tongtongwang86/steno/PCB/3d/SSD1306_OLED-0.91-128x32.step

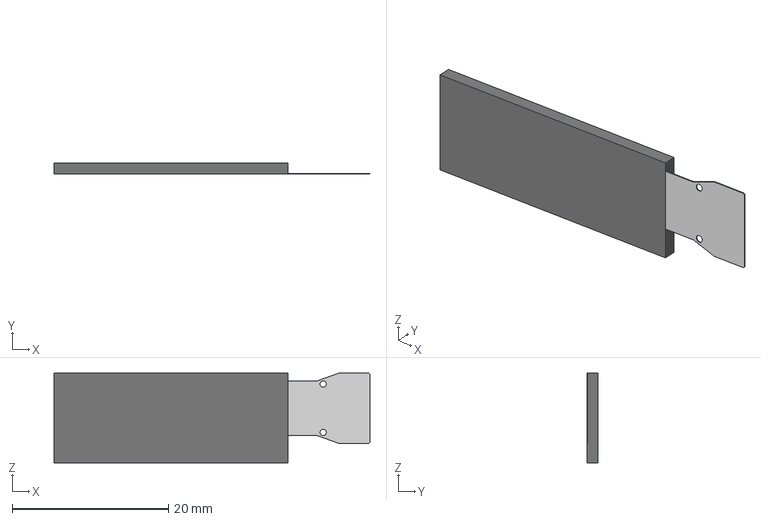
[picture p1: CAD file, 2025-06-24]
PCB/3d/SSD1306_OLED-0.91-128x32.step
40.5 x 1.45 x 11.5 mm
