tongtongwang86/steno/PCB/3d/APDS-9960.step

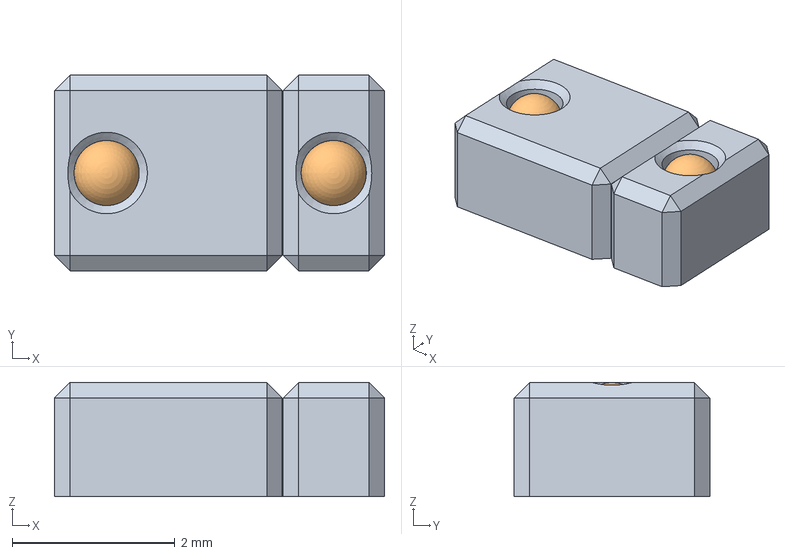
[picture p2: CAD file, 2025-06-24]
PCB/3d/APDS-9960.step
4.05 x 2.40 x 1.40 mm
