tongtongwang86/steno/PCB/3d/usbc.step

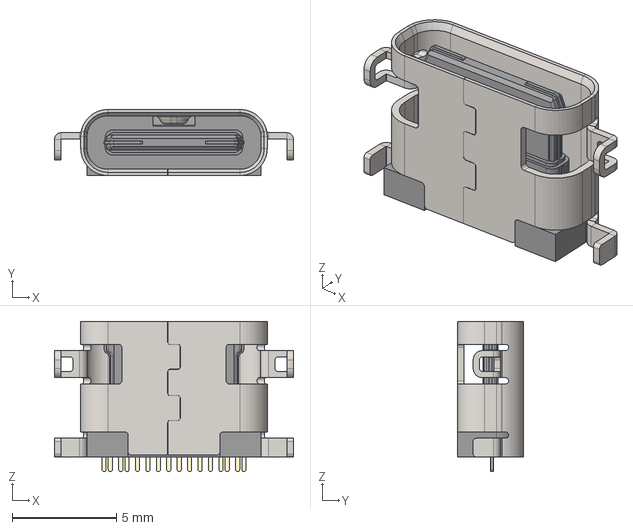
[picture p3: CAD file, 2025-06-24]
PCB/3d/usbc.step
11.5 x 3.16 x 7.20 mm
USB-C inboard metal
USB-C plastic
