tongtongwang86/steno/PCB/3d/WLCSP94_3P5X3P6_NOR.step

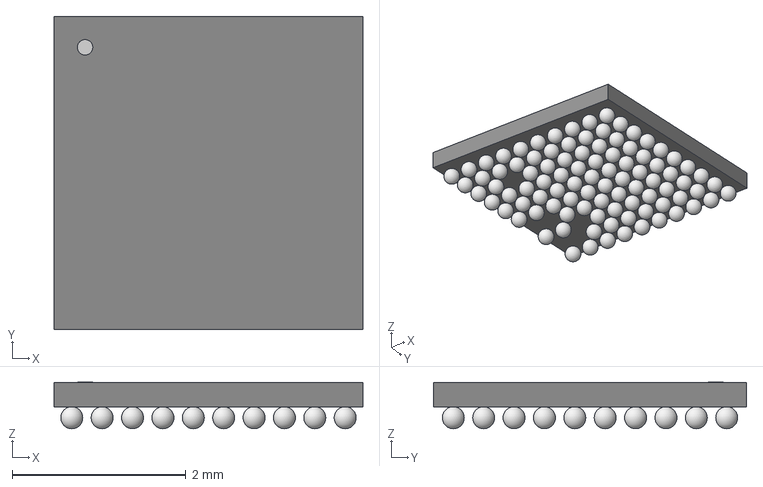
[picture p4: CAD file, 2025-06-24]
PCB/3d/WLCSP94_3P5X3P6_NOR.step
3.56 x 3.61 x 0.536 mm
