tongtongwang86/steno/PCB/3d/Chip Antenna.step

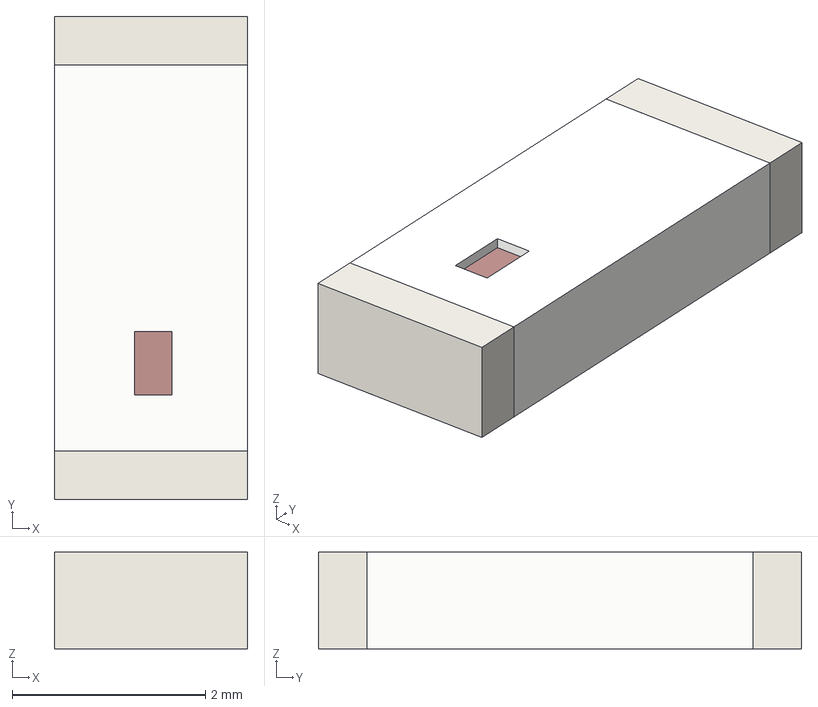
[picture p5: CAD file, 2025-06-24]
PCB/3d/Chip Antenna.step
2.00 x 5.00 x 1.00 mm
