tongtongwang86/steno/PCB/3d/CustomHotswap.step

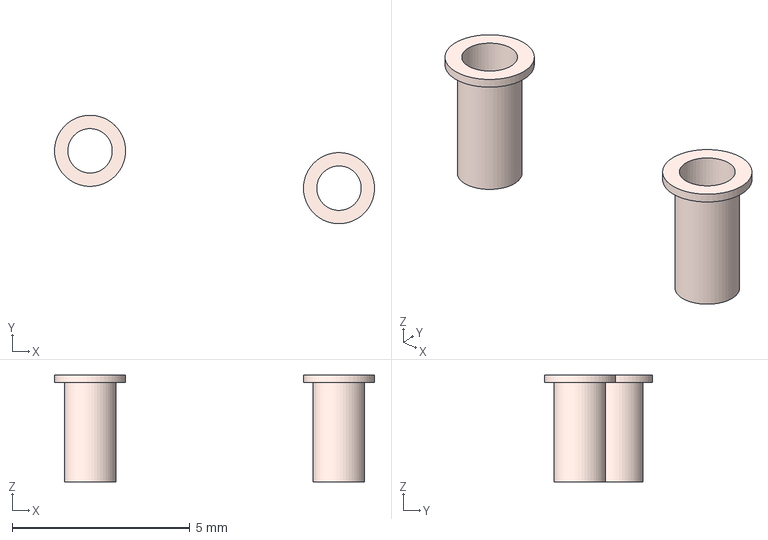
[picture p6: CAD file, 2025-06-24]
PCB/3d/CustomHotswap.step
9.00 x 3.05 x 3.00 mm
