tongtongwang86/steno/PCB/3d/pogo_T1836 v1.step

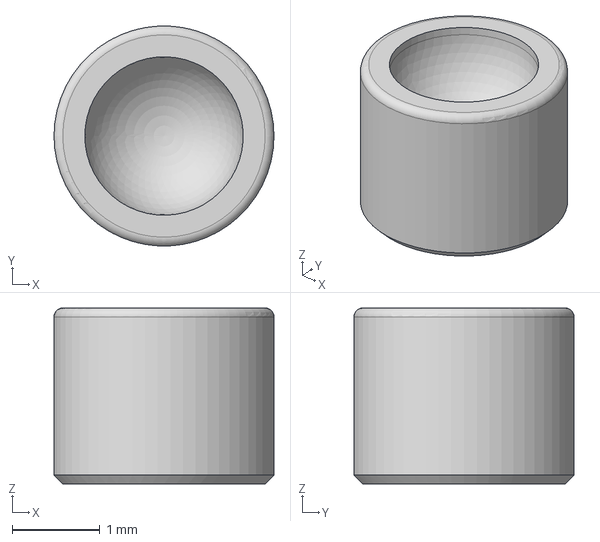
[picture p7: CAD file, 2025-06-24]
PCB/3d/pogo_T1836 v1.step
2.50 x 2.50 x 2.00 mm
