tongtongwang86/steno/PCB/3d/BK13C06-10DS2-0.35V_3D_STP.stp

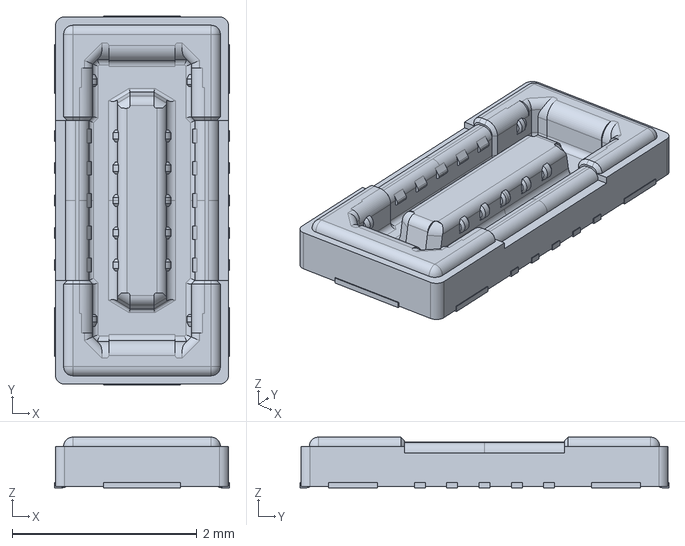
[picture p8: CAD file, 2025-06-24]
PCB/3d/BK13C06-10DS2-0.35V_3D_STP.stp
1.90 x 4.00 x 0.55 mm
