tongtongwang86/steno/PCB/3d/Inductor v1.step

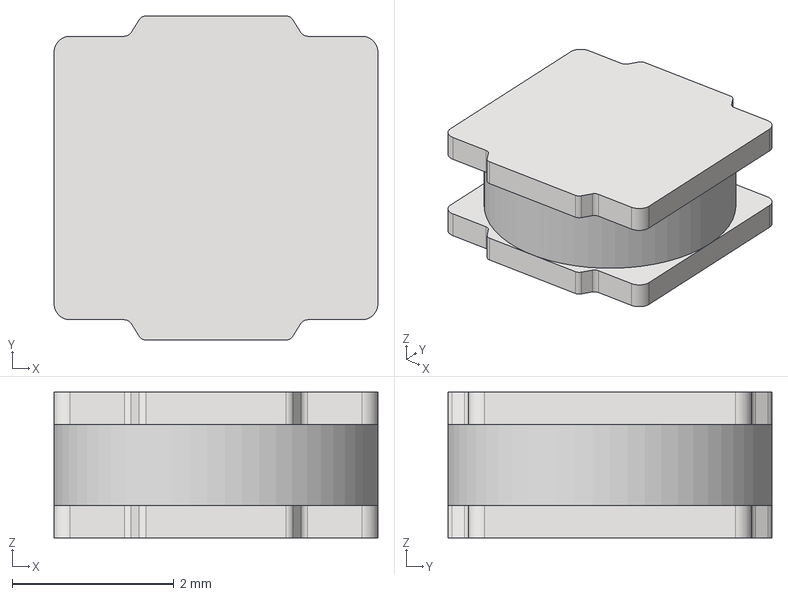
[picture p9: CAD file, 2025-06-24]
PCB/3d/Inductor v1.step
4.00 x 4.00 x 1.80 mm
