tongtongwang86/steno/PCB/3d/256Mbit GD25Q.step

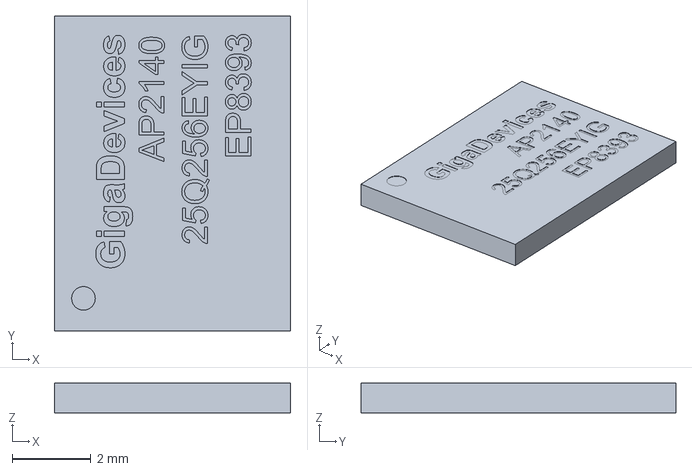
[picture p10: CAD file, 2025-06-24]
PCB/3d/256Mbit GD25Q.step
6.00 x 8.00 x 0.75 mm
