tongtongwang86/steno/PCB/3d/button v4.step

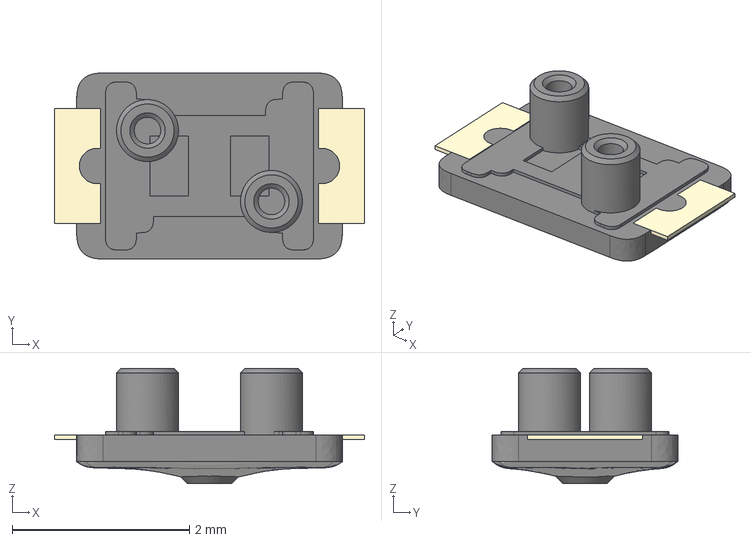
[picture p11: CAD file, 2025-06-24]
PCB/3d/button v4.step
3.50 x 2.10 x 1.30 mm
base
slider
