tongtongwang86/steno/PCB/3d/m3808 pogofemale v3.step

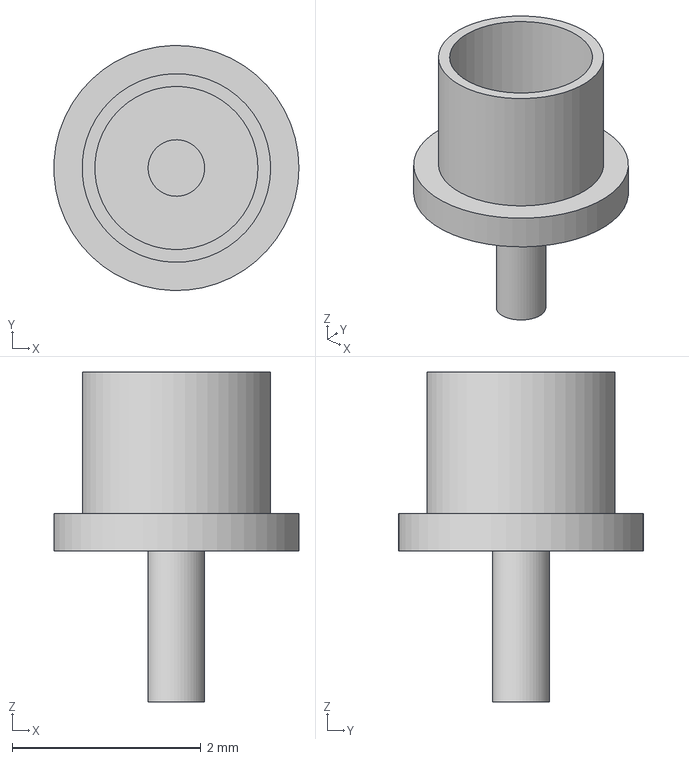
[picture p12: CAD file, 2025-06-24]
PCB/3d/m3808 pogofemale v3.step
2.60 x 2.60 x 3.50 mm
