tongtongwang86/steno/PCB/3d/USB2 v3.step

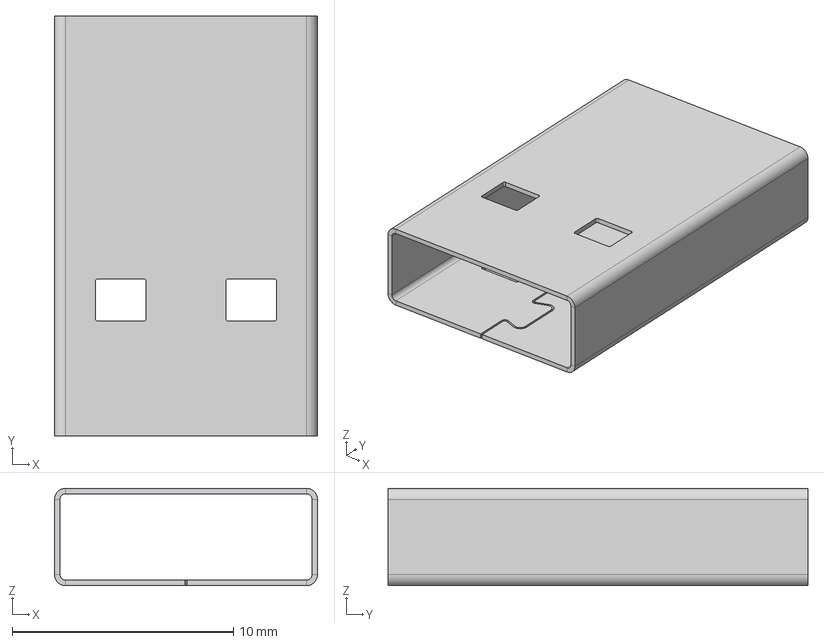
[picture p13: CAD file, 2025-06-24]
PCB/3d/USB2 v3.step
11.9 x 19.0 x 4.40 mm
