tongtongwang86/steno/PCB/3d/button3.step

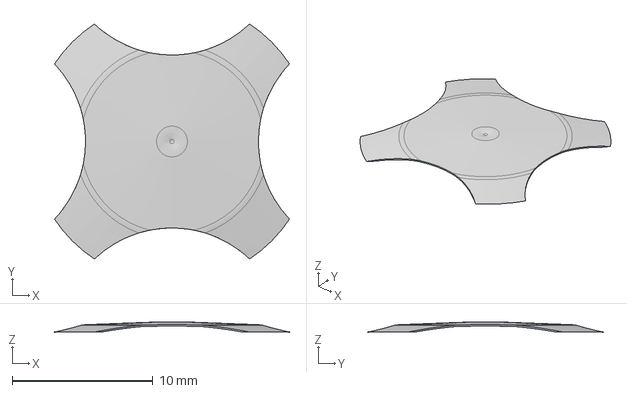
[picture p14: CAD file, 2025-06-24]
PCB/3d/button3.step
16.7 x 16.7 x 0.722 mm
