tongtongwang86/steno/PCB/3d/SW_Hotswap_Kailh_Choc_v1.stp

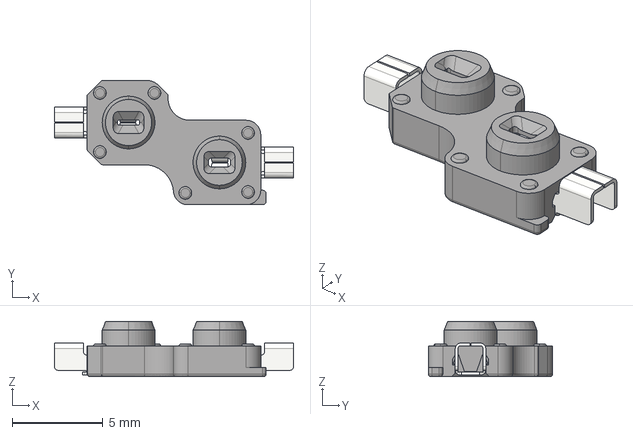
[picture p15: CAD file, 2025-06-24]
PCB/3d/SW_Hotswap_Kailh_Choc_v1.stp
13.2 x 6.85 x 3.05 mm
