tongtongwang86/steno/PCB/3d/Antenna.step

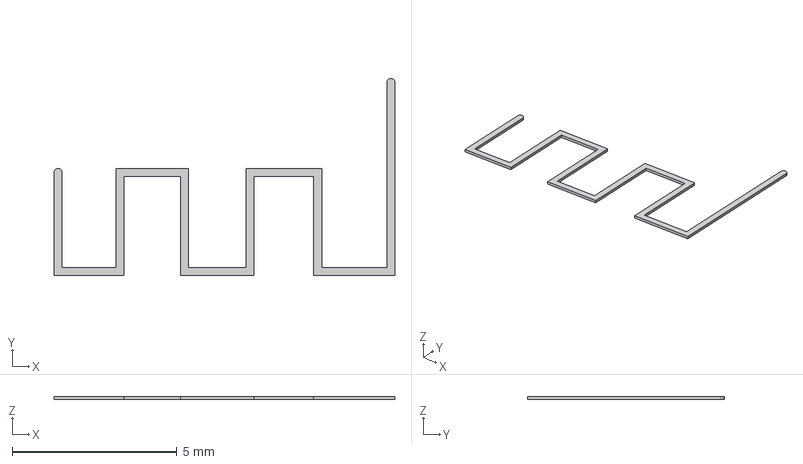
[picture p16: CAD file, 2025-06-24]
PCB/3d/Antenna.step
10.3 x 5.98 x 0.1 mm
