tongtongwang86/steno/PCB/3d/Battery2 v1.step

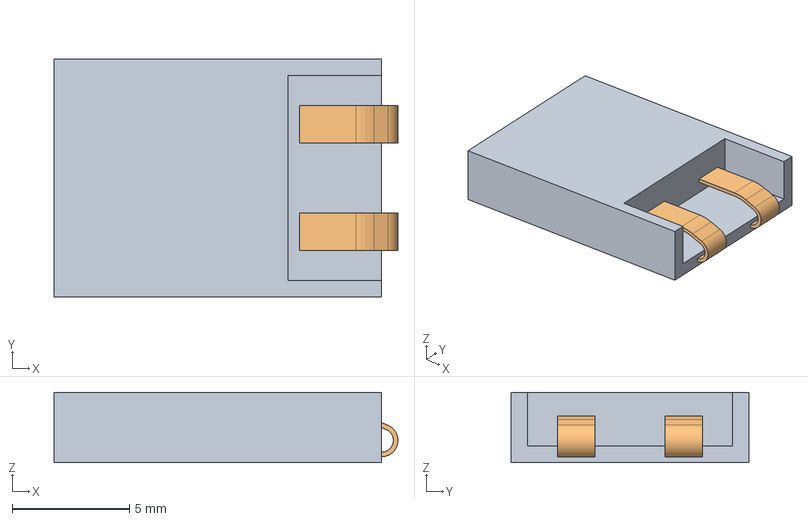
[picture p17: CAD file, 2025-06-24]
PCB/3d/Battery2 v1.step
14.7 x 10.2 x 3.00 mm
