tongtongwang86/steno/PCB/3d/buttoncompliant v4.step

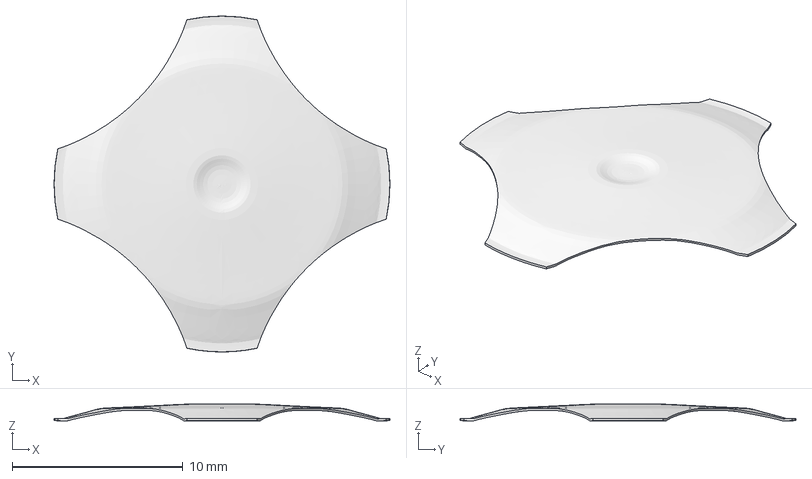
[picture p18: CAD file, 2025-06-24]
PCB/3d/buttoncompliant v4.step
19.7 x 19.7 x 0.979 mm
