tongtongwang86/steno/PCB/3d/FPC ZIF.step

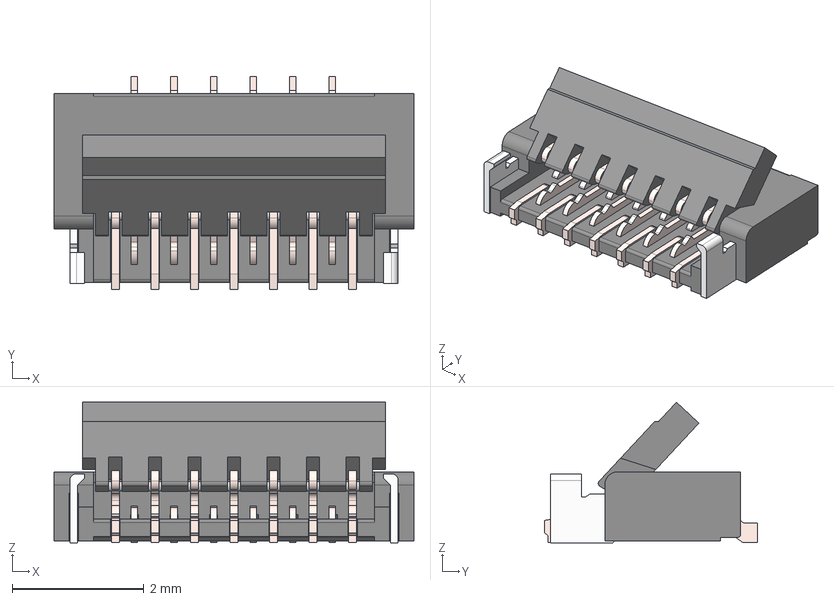
[picture p19: CAD file, 2025-06-24]
PCB/3d/FPC ZIF.step
5.46 x 3.23 x 2.13 mm
