tongtongwang86/steno/PCB/3d/KailhChocV2.step

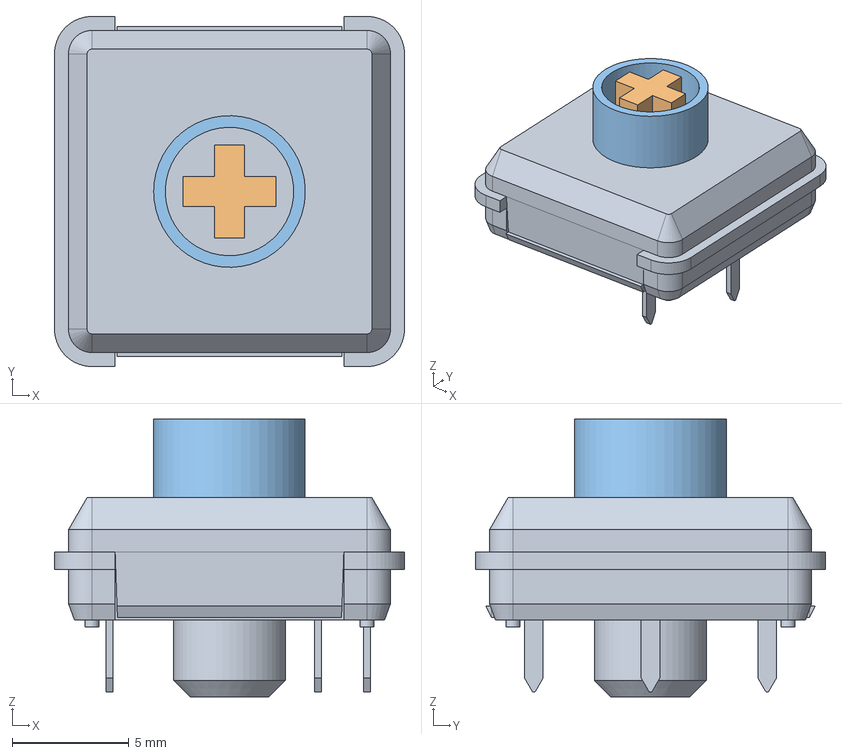
[picture p20: CAD file, 2025-06-24]
PCB/3d/KailhChocV2.step
15.0 x 15.0 x 11.9 mm
Plunger
