tongtongwang86/steno/PCB/3d/32MHZ Clock v1.step

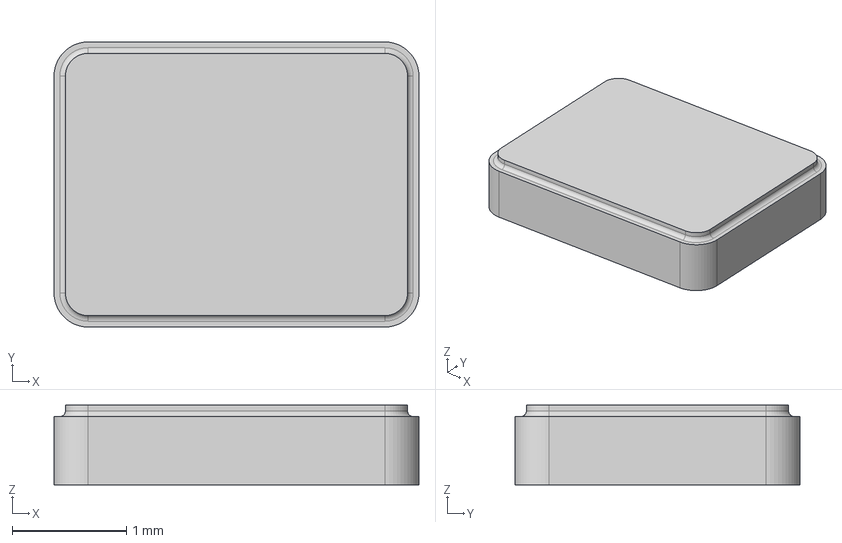
[picture p21: CAD file, 2025-06-24]
PCB/3d/32MHZ Clock v1.step
3.20 x 2.50 x 0.7 mm
