tongtongwang86/steno/PCB/3d/GateronHotswap v3.step

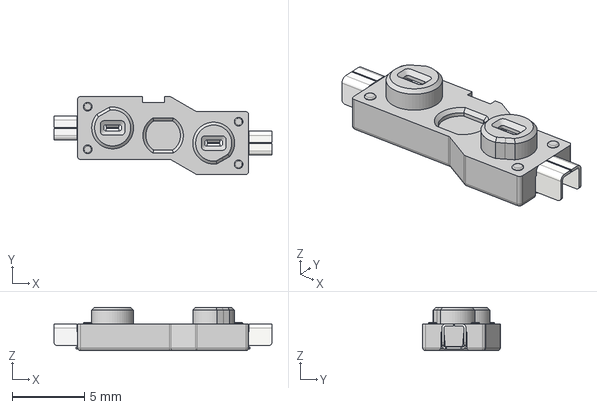
[picture p22: CAD file, 2025-06-24]
PCB/3d/GateronHotswap v3.step
15.1 x 5.39 x 3.00 mm
