tongtongwang86/steno/PCB/3d/Button.step

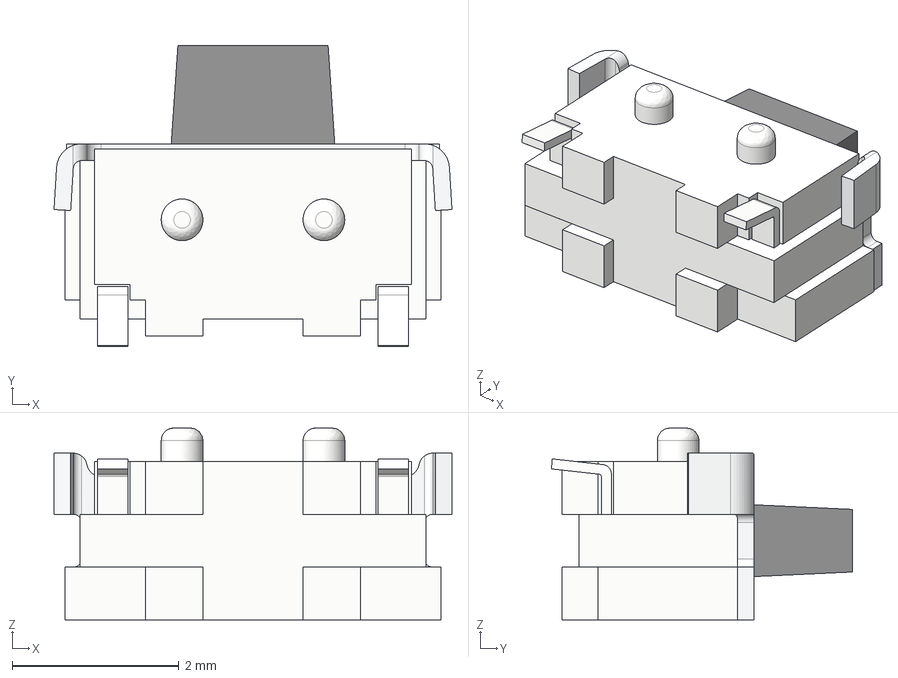
[picture p23: CAD file, 2025-06-24]
PCB/3d/Button.step
4.77 x 3.61 x 2.30 mm
Slider
