tongtongwang86/steno/PCB/3d/BK13C06-10DP2-0.35V_3D_STP.stp

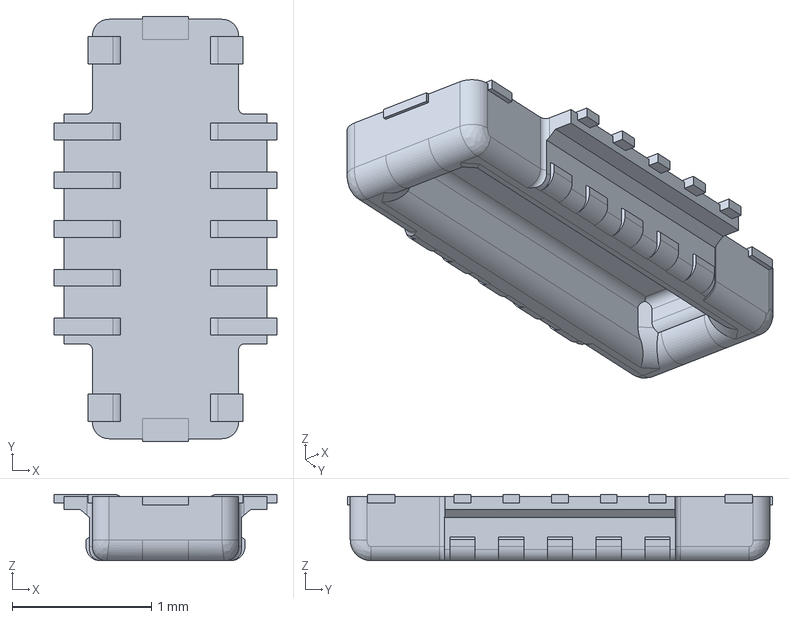
[picture p24: CAD file, 2025-06-24]
PCB/3d/BK13C06-10DP2-0.35V_3D_STP.stp
1.60 x 3.05 x 0.475 mm
