tongtongwang86/steno/PCB/3d/buttoncompliant.step

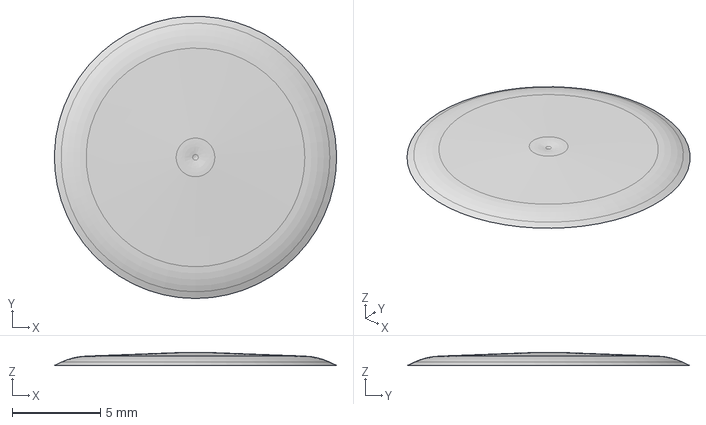
[picture p25: CAD file, 2025-06-24]
PCB/3d/buttoncompliant.step
16.0 x 16.0 x 0.722 mm
