tongtongwang86/steno/PCB/3d/BatteryBase.step

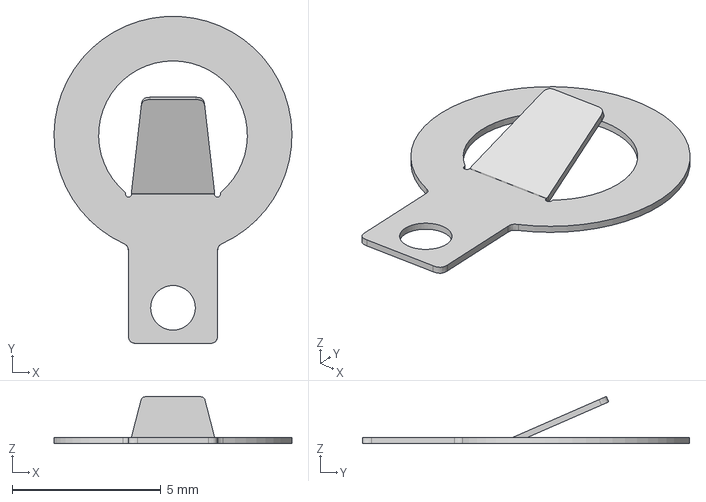
[picture p26: CAD file, 2025-06-24]
PCB/3d/BatteryBase.step
8.00 x 11.0 x 1.59 mm
