tongtongwang86/steno/PCB/3d/Battery v2.step

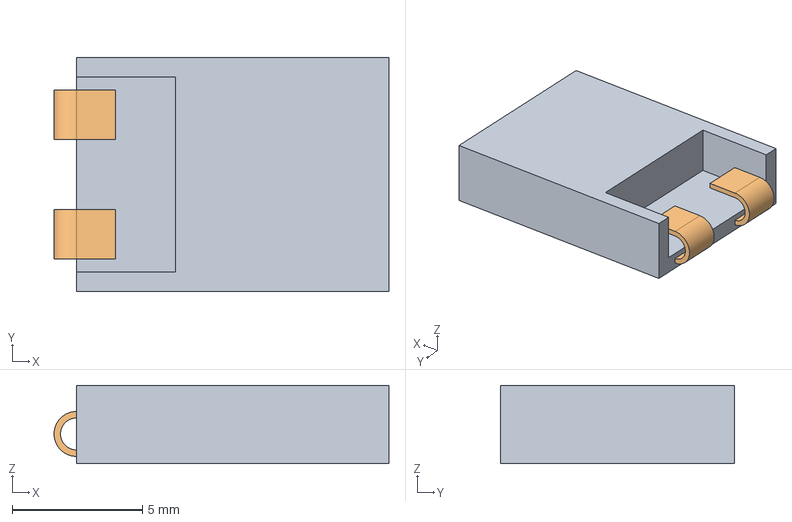
[picture p27: CAD file, 2025-06-24]
PCB/3d/Battery v2.step
12.9 x 9.00 x 3.00 mm
