tongtongwang86/steno/PCB/3d/Humidity.step

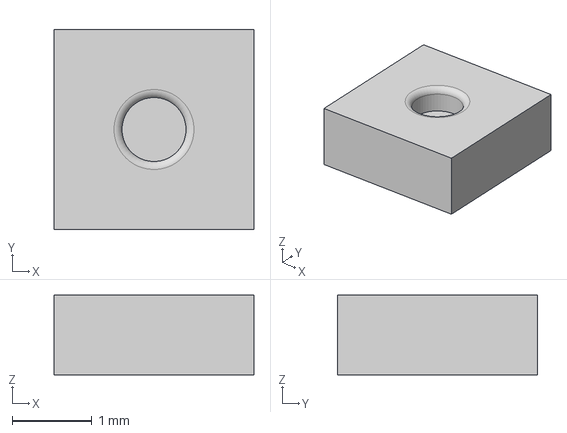
[picture p28: CAD file, 2025-06-24]
PCB/3d/Humidity.step
2.50 x 2.50 x 1.00 mm
