tongtongwang86/steno/PCB/3d/SPK0641HT4H-1.step

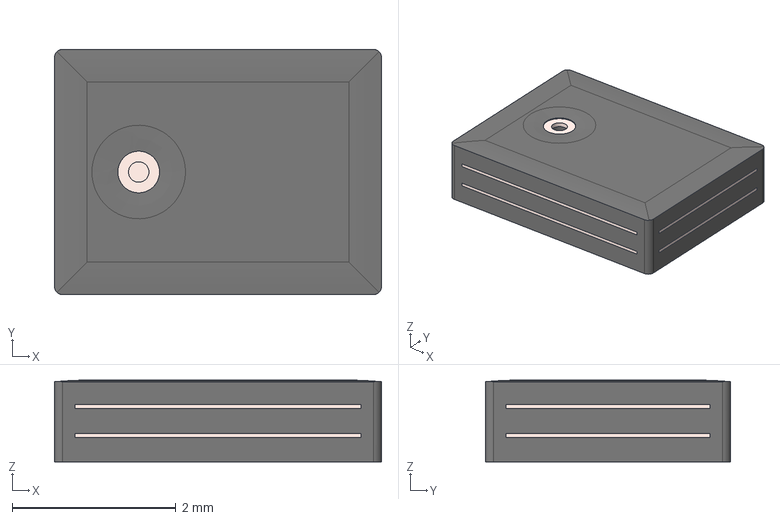
[picture p29: CAD file, 2025-06-24]
PCB/3d/SPK0641HT4H-1.step
4.00 x 3.00 x 1.00 mm
