tongtongwang86/steno/PCB/3d/Crystal 2 v0.step

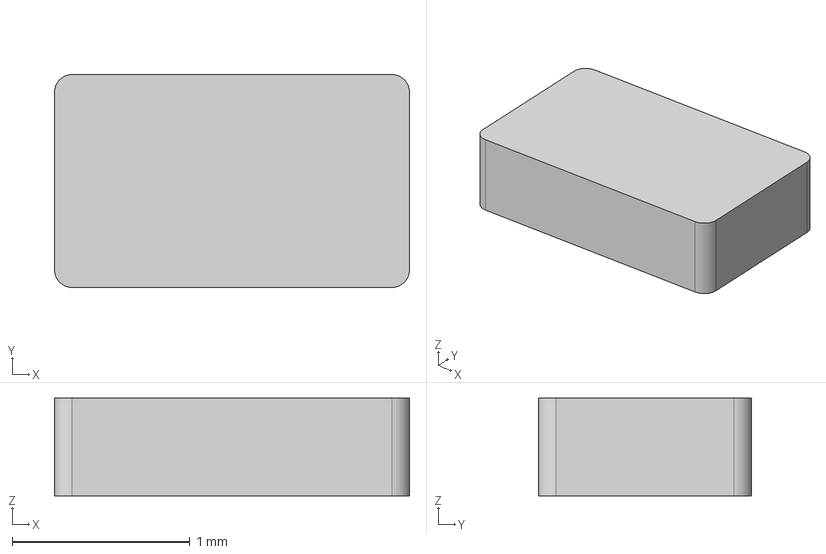
[picture p30: CAD file, 2025-06-24]
PCB/3d/Crystal 2 v0.step
2.00 x 1.20 x 0.55 mm
