tongtongwang86/steno/PCB/3d/LedV2 v4.step

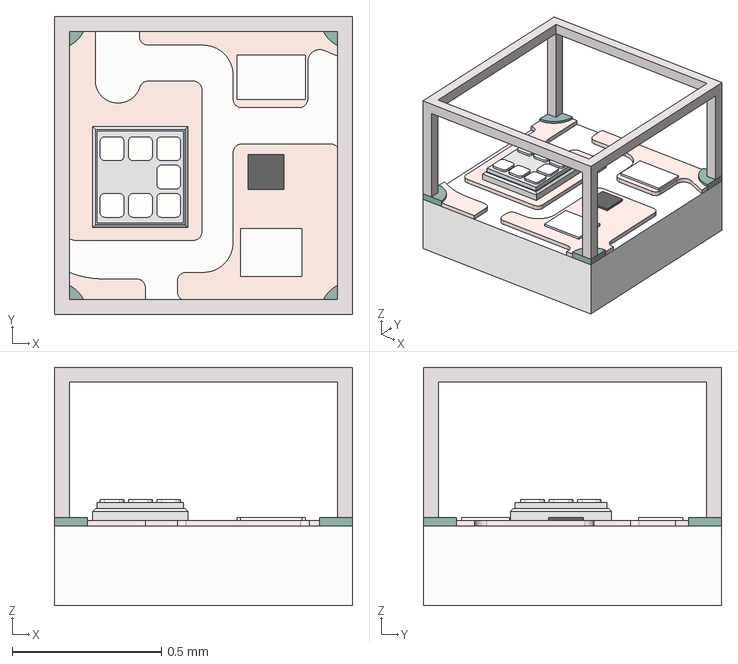
[picture p31: CAD file, 2025-06-24]
PCB/3d/LedV2 v4.step
1.00 x 1.00 x 0.8 mm
