tongtongwang86/steno/PCB/3d/TDFN-4 v1.step

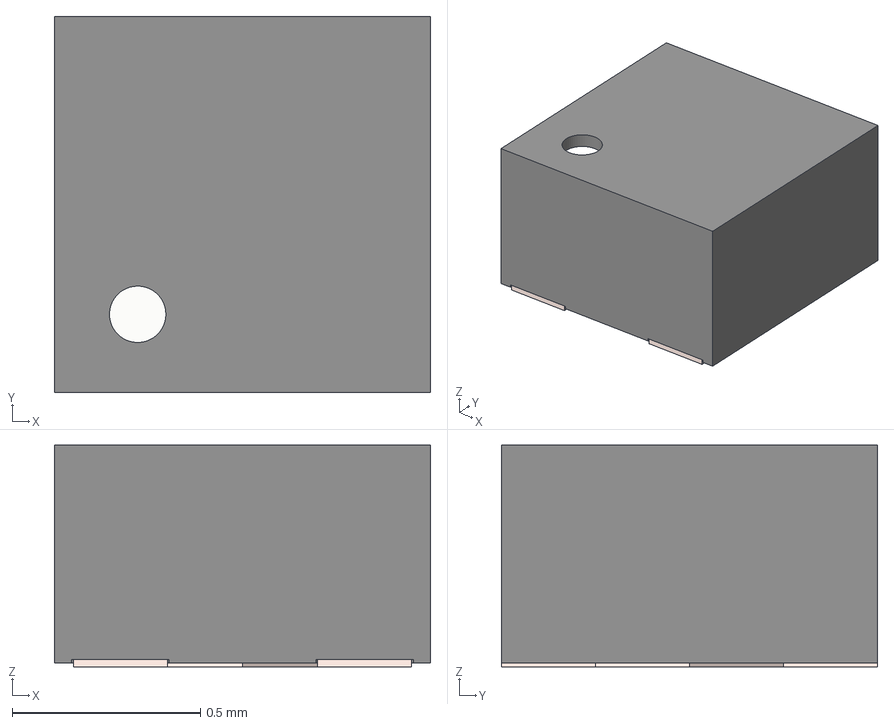
[picture p32: CAD file, 2025-06-24]
PCB/3d/TDFN-4 v1.step
1.00 x 1.00 x 0.59 mm
