tongtongwang86/steno/PCB/3d/QFN_2016_4pins.STEP

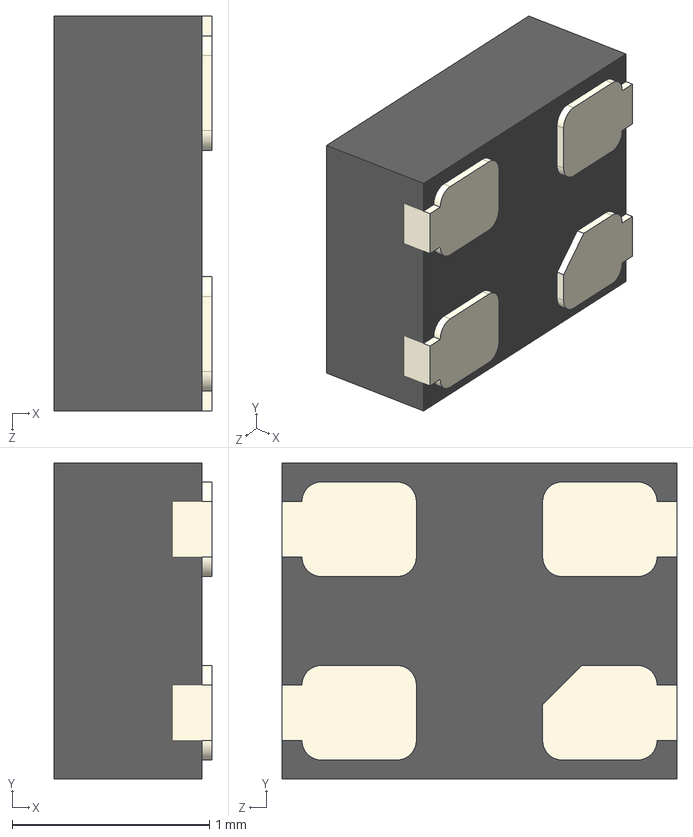
[picture p33: CAD file, 2025-06-24]
PCB/3d/QFN_2016_4pins.STEP
0.8 x 1.60 x 2.00 mm
