tongtongwang86/steno/PCB/3d/Pdmmic.step

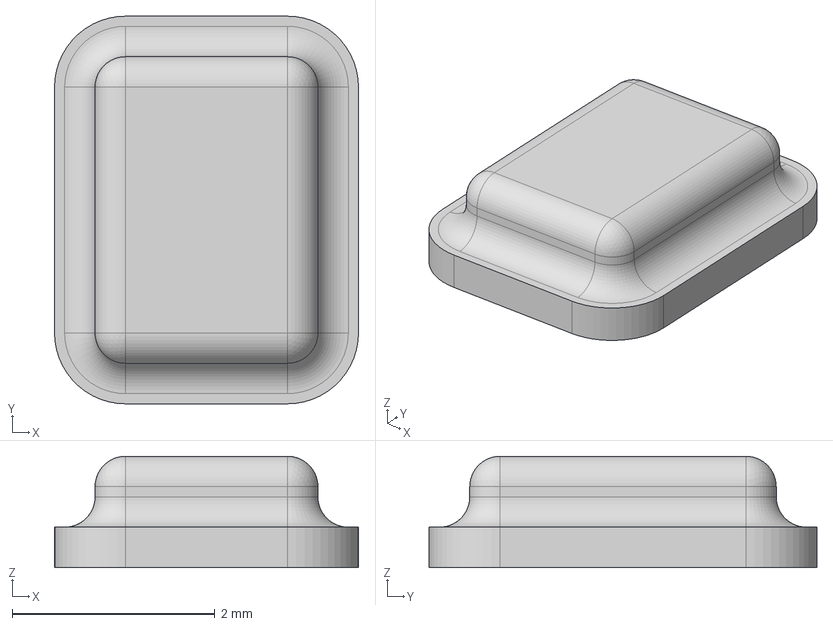
[picture p34: CAD file, 2025-06-24]
PCB/3d/Pdmmic.step
3.00 x 3.83 x 1.10 mm
