tongtongwang86/steno/PCB/3d/Speaker.step

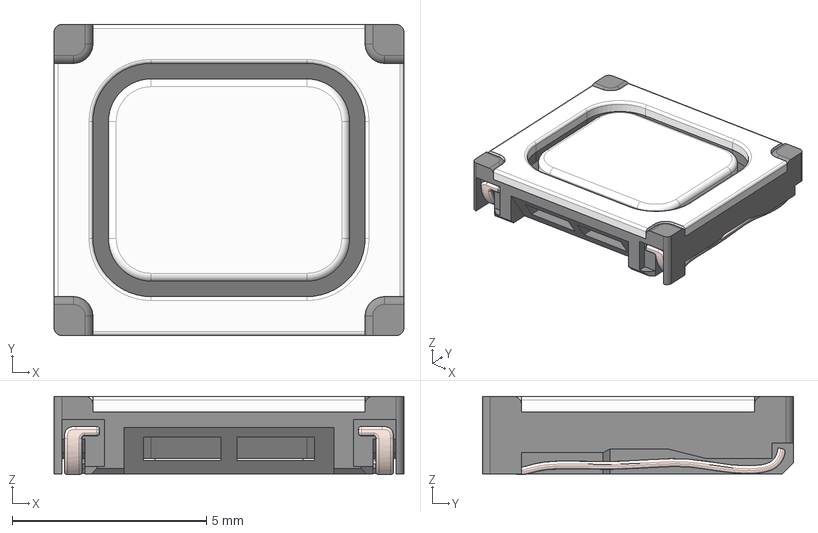
[picture p35: CAD file, 2025-06-24]
PCB/3d/Speaker.step
9.00 x 8.00 x 2.01 mm
bottom cap
case
diaphram
leg2
leg1
