tongtongwang86/steno/PCB/3d/5x5x1.7 v1.step

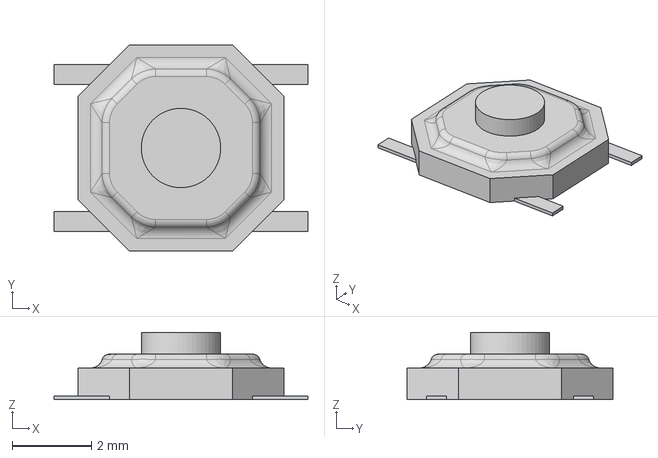
[picture p36: CAD file, 2025-06-24]
PCB/3d/5x5x1.7 v1.step
6.40 x 5.20 x 1.70 mm
