tongtongwang86/steno/(list of files, cad)

Other CAD files:
PCB/3d/USB - C inboard.step
PCB/3d/CSD17381F4.STEP
PCB/3d/NRF52832-CIAA-R.step
