tongtongwang86/steno/PCB/plots/Steno__Assembly.pdf

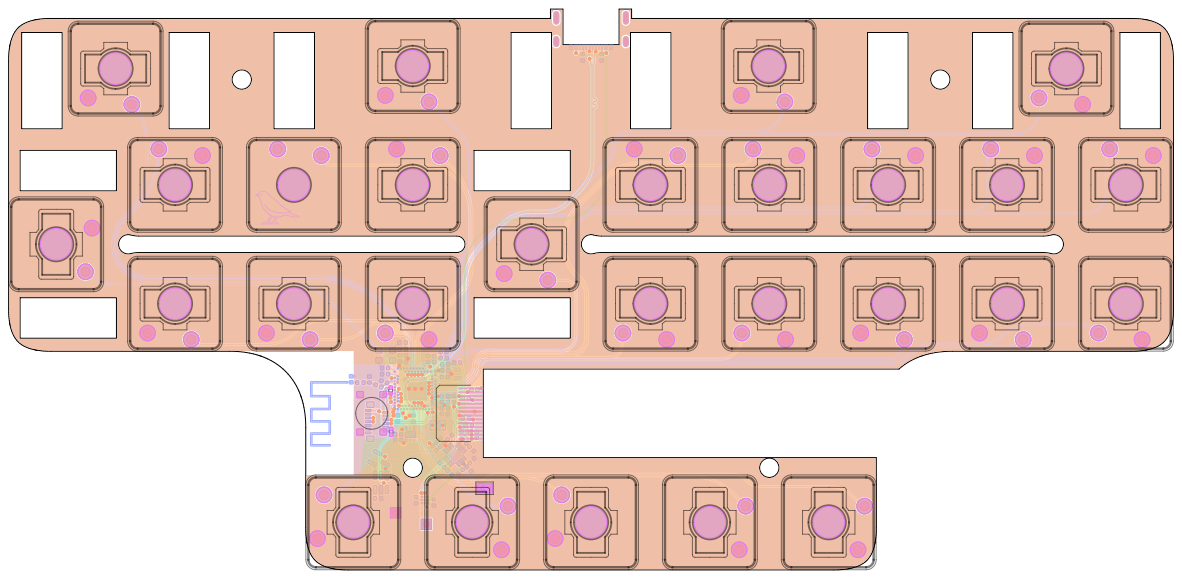
[picture p37: page 1]
