tongtongwang86/steno/PCB/Steno.kicad_pcb

## KiCad design PCB/Steno.kicad_pcb (2025-07-06)

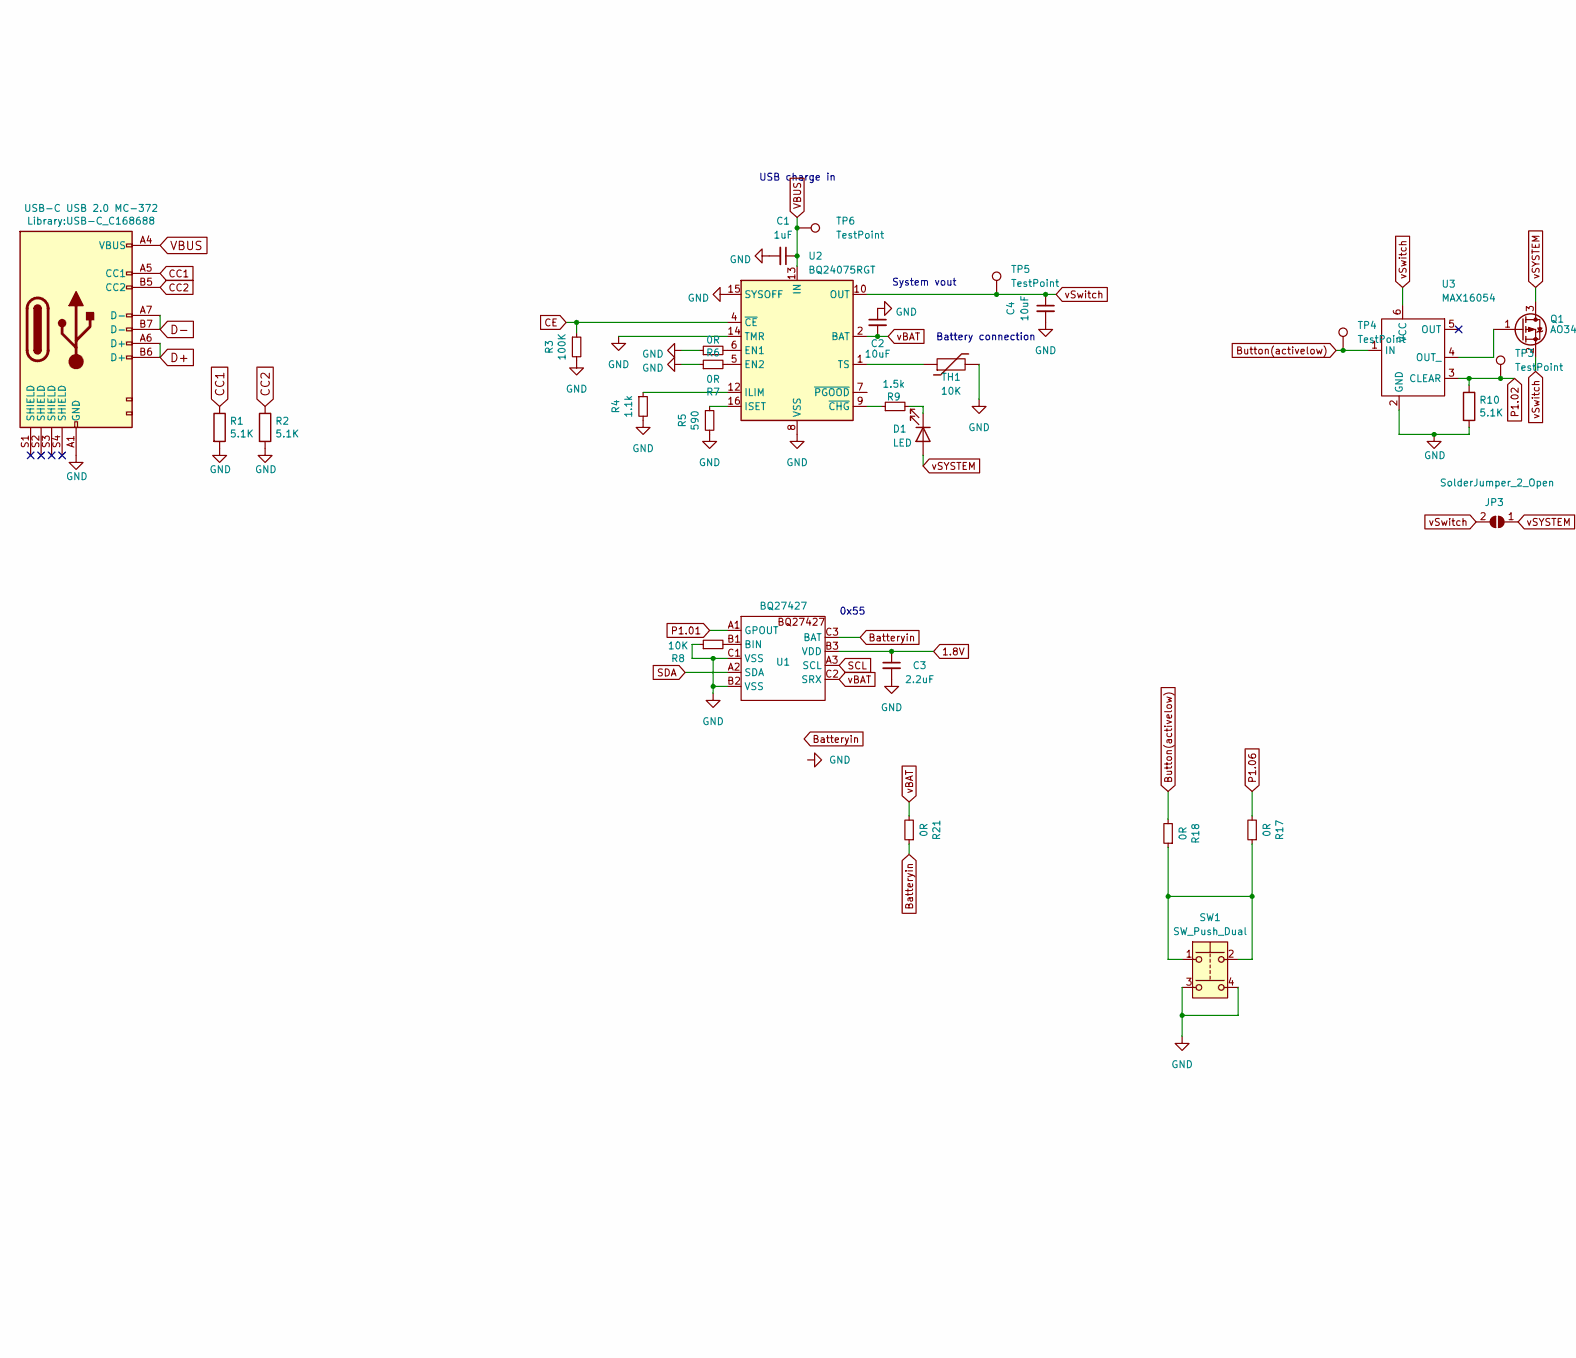
[picture p38: schematic Steno.kicad_sch, part in row 1, column 1]

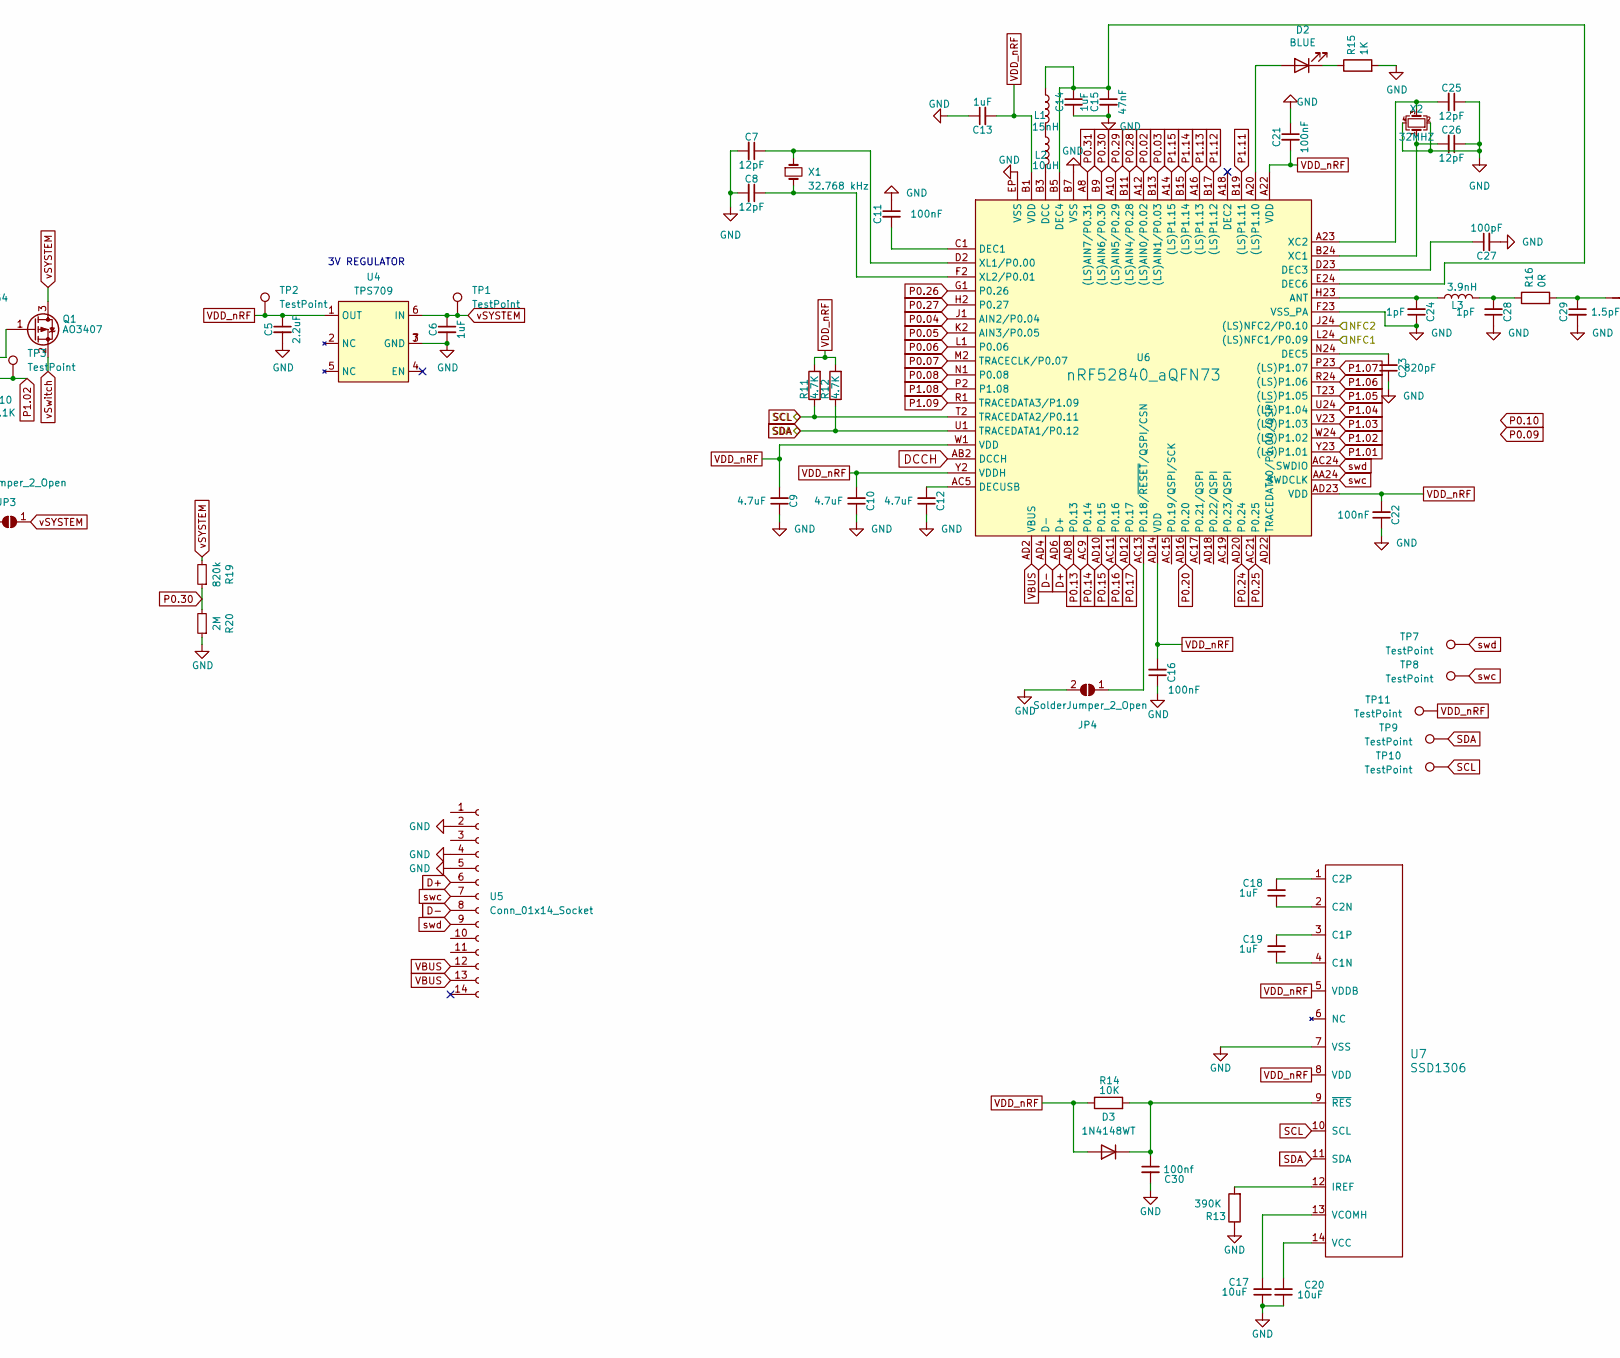
[picture p39: schematic Steno.kicad_sch, part in row 1, column 2]

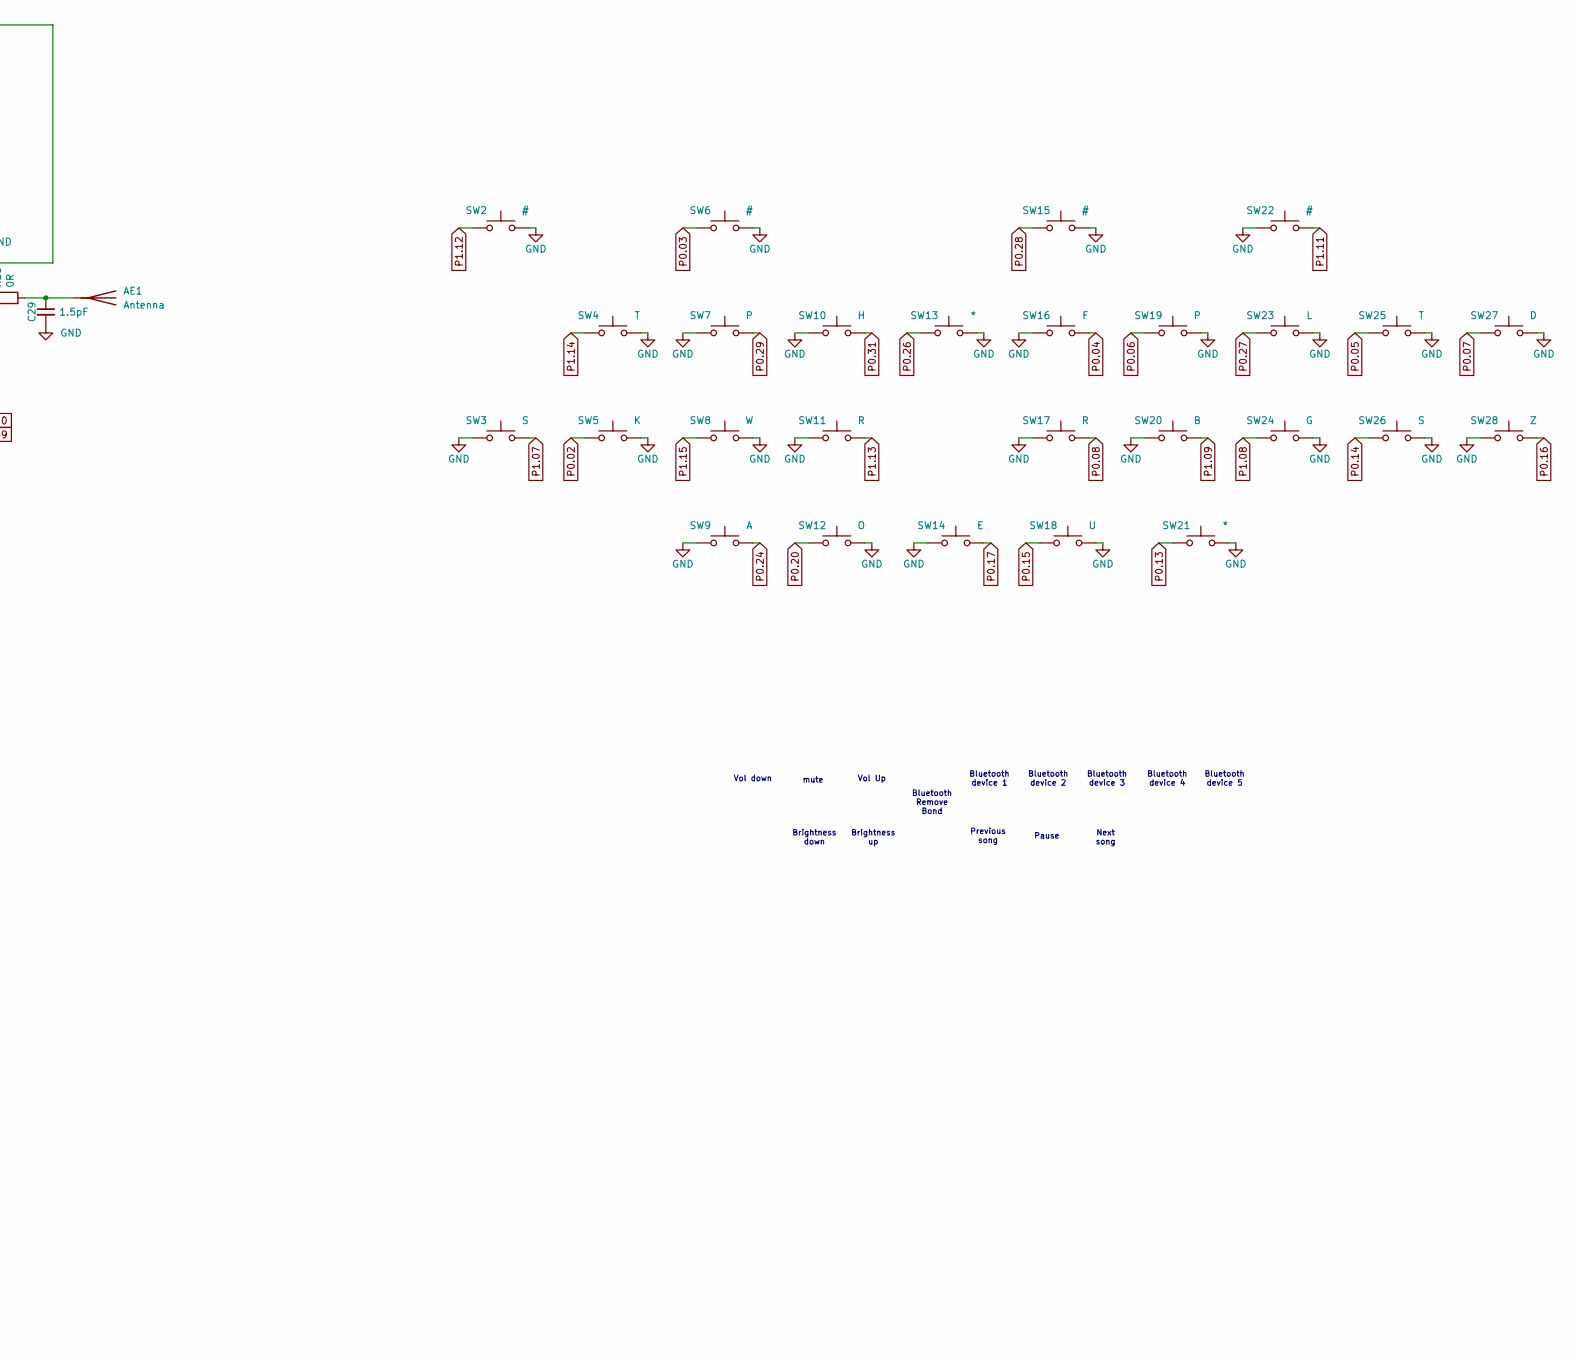
[picture p40: schematic Steno.kicad_sch, part in row 1, column 3]

Parts:
AE1: Antenna; 2.4GHz-meander-antenna-v2
C1, C6: 1uF; 0402
C2, C4, C17, C20: 10uF; 0402
C3, C5: 2.2uF; 0402
C7, C8, C25, C26: 12pF; C_0402_1005Metric
C9, C10, C12: 4.7uF; C_0402_1005Metric
C11, C16, C21, C22: 100nF; C_0402_1005Metric
C13, C14, C18, C19: 1uF; C_0402_1005Metric
C15: 47nF; C_0402_1005Metric
C23: 820pF; C_0402_1005Metric
C24, C28: 1pF; C_0402_1005Metric
C27: 100pF; C_0402_1005Metric
C29: 1.5pF; C_0402_1005Metric
C30: 100nf; C_0402_1005Metric
D1: LED; 0402
D2: BLUE; LED_0402_1005Metric
D3: 1N4148WT; D_SOD-523
J1: USB-C USB 2.0 MC-372; USB-C_C168688
JP3, JP4: SolderJumper_2_Open; SolderJumper-2_P1.3mm_Open_TrianglePad1.0x1.5mm
L1: 15nH; L_0402_1005Metric
L2: 10uH; L_0402_1005Metric
L3: 3.9nH; L_0402_1005Metric
Q1: AO3407; SOT-23
R1, R2, R10: 5.1K; R_0402_1005Metric
R3: 100K; 0402
R4: 1.1k; 0402
R5: 590; 0402
R6, R7, R16, R17, R18, R21: 0R; 0402
R8, R14: 10K; 0402
R9: 1.5k; 0402
R11, R12: 4.7K; R_0402_1005Metric
R13: 390K; R_0402_1005Metric
R15: 1K; R_0402_1005Metric
R19: 820k; 0402
R20: 2M; 0402
SW1: SW_Push_Dual; 5x5button
SW2, SW6, SW15, SW22: #; CustomHotswap
SW3, SW26: S; CustomHotswap
SW4, SW25: T; CustomHotswap
SW5: K; CustomHotswap
SW7, SW19: P; CustomHotswap
SW8: W; CustomHotswap
SW9: A; CustomHotswap
SW10: H; CustomHotswap
SW11, SW17: R; CustomHotswap
SW12: O; CustomHotswap
SW13, SW21: *; CustomHotswap
SW14: E; CustomHotswap
SW16: F; CustomHotswap
SW18: U; CustomHotswap
SW20: B; CustomHotswap
SW23: L; CustomHotswap
SW24: G; CustomHotswap
SW27: D; CustomHotswap
SW28: Z; CustomHotswap
TH1: 10K; 0402
TP1, TP2, TP3, TP4, TP5, TP6, TP7, TP8, TP9, TP10, TP11: TestPoint; testPads
U1: BQ27427; Texas_DSBGA-9_1.62mmx1.58mm_Layout3x3_P0.5mm
U2: BQ24075RGT; VQFN-16-1EP_3x3mm_P0.5mm_EP1.6x1.6mm
U3: MAX16054; SOT-23-6
U4: TPS709; DRV 6PIN
U5: Conn_01x14_Socket; FPC
U6: nRF52840_aQFN73; AQFN-73-1EP_7x7mm_P0.5mm_NRF52840-custom
U7: SSD1306; SSD1306_OLED-0.91-128x32
X1: 32.768 kHz; Crystal_SMD_2012-2Pin_2.0x1.2mm; Manufacturer Part SC20S-12.5PF20PPM; LCSC Part C97607
X2: 32MHZ; crystal 32mhz

Connections:
1.8V: C3.1, U1.B3 (VDD)
/NFC1: U6.L24 ((LS)NFC1/P0.09)
/NFC2: U6.J24 ((LS)NFC2/P0.10)
Batteryin: R21.1, U1.C3 (BAT)
Button(activelow): R18.2, TP4.1, U3.1 (IN)
CC1: J1.A5 (CC1), R1.1
CC2: J1.B5 (CC2), R2.1
CE: R3.1, U2.4 (~CE)
D+: J1.A6 (D+), J1.B6 (D+), U5.6, U6.AD6 (D+)
D-: J1.A7 (D-), J1.B7 (D-), U5.8, U6.AD4 (D-)
DCCH: U6.AB2 (DCCH)
GND: C1.2, C2.1, C3.2, C4.2, C5.2, C6.2, C7.2, C8.2, C9.1, C10.1, C11.1, C12.1, C13.1, C14.2, C15.2, C16.1, C17.1, C20.1, C21.1, C22.1, C23.1, C24.1, C25.1, C26.1, C27.2, C28.1, C29.2, C30.2, J1.A1 (GND), JP4.2 (B), R1.2, R2.2, R3.2, R4.2, R5.2, R6.1, R7.1, R8.1, R10.2, R13.1, R15.2, R20.1, SW1.3, SW1.4, SW2.2, SW3.1, SW4.2, SW5.2, SW6.2, SW7.1, SW8.2, SW9.1, SW10.1, SW11.1, SW12.2, SW13.2, SW14.1, SW15.2, SW16.1, SW17.1, SW18.2, SW19.2, SW20.1, SW21.2, SW22.1, SW23.2, SW24.2, SW25.2, SW26.2, SW27.2, SW28.1, TH1.2, U1.B2 (VSS), U1.C1 (VSS), U2.8 (VSS), U2.14 (TMR), U2.15 (SYSOFF), U2.17 (VSS), U3.2 (GND), U4.3 (GND), U4.7 (GND), U5.2, U5.4, U5.5, U6.B7 (VSS), U6.EP (VSS), U6.F23 (VSS_PA), U7.7 (VSS), X2.2, X2.4
unnamed: AE1.1 (A), C29.1, R16.2
unnamed: C28.2, L3.2, R16.1
unnamed: D1.1 (K), R9.2
unnamed: D2.2 (A), U6.A20 ((LS)P1.10)
unnamed: D2.1 (K), R15.1
unnamed: C30.1, D3.1 (K), R14.2, U7.9 (~RES)
unnamed: JP4.1 (A), U6.AC13 (P0.18/~RESET/QSPI/CSN)
unnamed: L1.2, L2.1
unnamed: Q1.1 (G), U3.4 (OUT_)
unnamed: R17.1, R18.1, SW1.1, SW1.2
unnamed: R8.2, U1.B1 (BIN)
unnamed: R6.2, U2.6 (EN1)
unnamed: R7.2, U2.5 (EN2)
unnamed: R4.1, U2.12 (ILIM)
unnamed: R5.1, U2.16 (ISET)
unnamed: TH1.1, U2.1 (TS)
unnamed: R9.1, U2.9 (~CHG)
unnamed: C24.2, L3.1, U6.H23 (ANT)
unnamed: L2.2, U6.B3 (DCC)
unnamed: C11.2, U6.C1 (DEC1)
unnamed: C27.1, U6.D23 (DEC3)
unnamed: C14.1, C15.1, L1.1, U6.B5 (DEC4), U6.E24 (DEC6)
unnamed: C23.2, U6.N24 (DEC5)
unnamed: C12.2, U6.AC5 (DECUSB)
unnamed: C26.2, U6.B24 (XC1), X2.1
unnamed: C25.2, U6.A23 (XC2), X2.3
unnamed: C7.1, U6.D2 (XL1/P0.00), X1.1
unnamed: C8.1, U6.F2 (XL2/P0.01), X1.2
unnamed: C19.1, U7.4 (C1N)
unnamed: C19.2, U7.3 (C1P)
unnamed: C18.1, U7.2 (C2N)
unnamed: C18.2, U7.1 (C2P)
unnamed: R13.2, U7.12 (IREF)
unnamed: C20.2, U7.14 (VCC)
unnamed: C17.2, U7.13 (VCOMH)
P0.02: SW5.1, U6.A12 ((LS)AIN0/P0.02)
P0.03: SW6.1, U6.B13 ((LS)AIN1/P0.03)
P0.04: SW16.2, U6.J1 (AIN2/P0.04)
P0.05: SW25.1, U6.K2 (AIN3/P0.05)
P0.06: SW19.1, U6.L1 (P0.06)
P0.07: SW27.1, U6.M2 (TRACECLK/P0.07)
P0.08: SW17.2, U6.N1 (P0.08)
P0.13: SW21.1, U6.AD8 (P0.13)
P0.14: SW26.1, U6.AC9 (P0.14)
P0.15: SW18.1, U6.AD10 (P0.15)
P0.16: SW28.2, U6.AC11 (P0.16)
P0.17: SW14.2, U6.AD12 (P0.17)
P0.20: SW12.1, U6.AD16 (P0.20)
P0.24: SW9.2, U6.AD20 (P0.24)
P0.25: U6.AC21 (P0.25)
P0.26: SW13.1, U6.G1 (P0.26)
P0.27: SW23.1, U6.H2 (P0.27)
P0.28: SW15.1, U6.B11 ((LS)AIN4/P0.28)
P0.29: SW7.2, U6.A10 ((LS)AIN5/P0.29)
P0.30: R19.1, R20.2, U6.B9 ((LS)AIN6/P0.30)
P0.31: SW10.2, U6.A8 ((LS)AIN7/P0.31)
P1.01: U1.A1 (GPOUT), U6.Y23 ((LS)P1.01)
P1.02: R10.1, TP3.1, U3.3 (CLEAR), U6.W24 ((LS)P1.02)
P1.03: U6.V23 ((LS)P1.03)
P1.04: U6.U24 ((LS)P1.04)
P1.05: U6.T23 ((LS)P1.05)
P1.06: R17.2, U6.R24 ((LS)P1.06)
P1.07: SW3.2, U6.P23 ((LS)P1.07)
P1.08: SW24.1, U6.P2 (P1.08)
P1.09: SW20.2, U6.R1 (TRACEDATA3/P1.09)
P1.11: SW22.2, U6.B19 ((LS)P1.11)
P1.12: SW2.1, U6.B17 ((LS)P1.12)
P1.13: SW11.2, U6.A16 ((LS)P1.13)
P1.14: SW4.1, U6.B15 ((LS)P1.14)
P1.15: SW8.1, U6.A14 ((LS)P1.15)
SCL: R11.1, TP10.1, U1.A3 (SCL), U6.T2 (TRACEDATA2/P0.11), U7.10 (SCL)
SDA: R12.1, TP9.1, U1.A2 (SDA), U6.U1 (TRACEDATA1/P0.12), U7.11 (SDA)
VBUS: C1.1, J1.A4 (VBUS), TP6.1, U2.13 (IN), U5.12, U5.13, U6.AD2 (VBUS)
VDD_nRF: C5.1, C9.2, C10.2, C13.2, C16.2, C21.2, C22.2, D3.2 (A), R11.2, R12.2, R14.1, TP2.1, TP11.1, U4.1 (OUT), U6.A22 (VDD), U6.AD14 (VDD), U6.AD23 (VDD), U6.B1 (VDD), U6.W1 (VDD), U6.Y2 (VDDH), U7.5 (VDDB), U7.8 (VDD)
swc: TP8.1, U5.7, U6.AA24 (SWDCLK)
swd: TP7.1, U5.9, U6.AC24 (SWDIO)
vBAT: C2.2, R21.2, U1.C2 (SRX), U2.2 (BAT), U2.3 (BAT)
vSYSTEM: C6.1, D1.2 (A), JP3.1 (A), Q1.3 (D), R19.2, TP1.1, U4.6 (IN)
vSwitch: C4.1, JP3.2 (B), Q1.2 (S), TP5.1, U2.10 (OUT), U2.11 (OUT), U3.6 (VCC)

Notes on the sheet:
Previous song
Bluetooth device 4
Bluetooth device 2
Next song
USB charge in
System vout
Pause
Bluetooth device 3
Brightness down
3V REGULATOR
Bluetooth device 5
Brightness up
Bluetooth device 1
0x55
Battery connection
mute
Vol Up
Vol down
Bluetooth Remove Bond

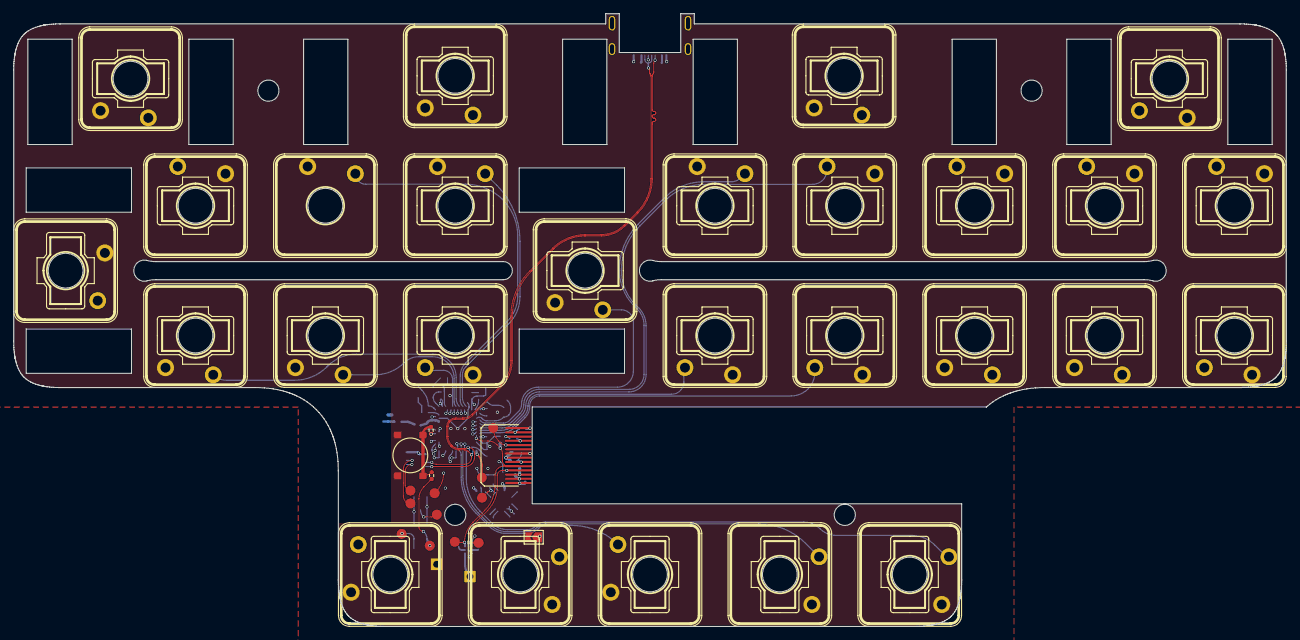
[picture p41: board Steno.kicad_pcb from above]

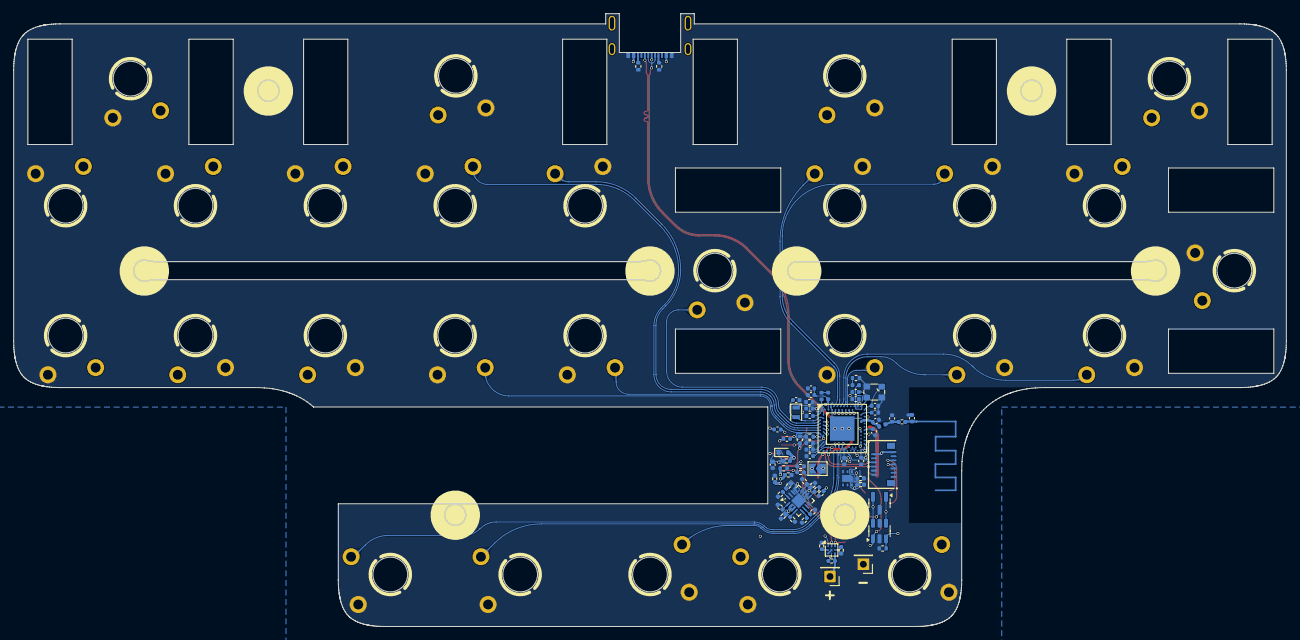
[picture p42: board Steno.kicad_pcb from below]

Board: 4 copper layers, 186.7 x 89.9 mm, 111 parts (69 on the bottom side), 84 nets.
