tongtongwang86/steno/(commit log)

2025-06-07 new board
2025-06-07 added pincontrol for i2c0
2025-06-07 i2c oled
2025-06-07 fixed i2c pins
2025-06-07 fast i2c
2025-06-07 dedicated ui thread
2025-06-13 switch i2c pins
2025-06-24 added pcb
    [256Mbit GD25Q.step, 32MHZ Clock v1.step, 5x5x1.7 v1.step, APDS-9960.step, Antenna.step, BK13C06-10DP2-0.35V_3D_STP.stp, BK13C06-10DS2-0.35V_3D_STP.stp, Battery v2.step]
2025-06-30 new keymap for new pcb
2025-06-30 voltage divider for battery
2025-06-30 show battery percentage
2025-06-30 fuel gauge calibration
2025-07-06 try fuel gauge again
    [Steno.kicad_pcb, Steno.kicad_sch]
2026-09-23 firmware: on-device steno engine, compressed dictionary, framebuffer OLED
    Replaces boards/arm/steno with boards/stenolab/steno (Zephyr hardware
    model v2). The keyboard now translates steno on-device instead of sending
    keycodes; no host-side Plover required.
    Dictionary (dict/, customfirmware/tools/mkdict.py)
    Plover's main.json compressed to an SDIC image read in place from
    internal flash: Re-Pair grammar compression plus canonical Huffman,
    three streams (keys / value pool / value ids), position independent.
    147,424 entries in 796 KB, 5.53 B/entry. Reader is 1,142 B of flash,
    zero static RAM, 744 B stack. Re-Pair beat zstd because a zstd decoder
    is 30-60 KB of code and needs a 32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
    [main.c]
2026-09-23 engine: orthography, number bar, carry-capitalize; fix drop-derivable
    Verified against traces from the real Plover engine, 20,002 strokes:
    97.8% -> 99.7% byte-exact. Against Plover forced onto its own
    no-word-list path (apples to apples, since american_english_words.txt is
    4.3 MB and cannot ship): 99.9%.
    Orthography (steno/steno_ortho.c, 3,198 B)
    Plover's 38 ORTHOGRAPHY_RULES hand-compiled to C predicates, tried in
    order, first match wins - its no-dictionary fallback path. Verified in
    isolation: 12,800/12,800 joins identical to Plover, including the
    negative-lookbehind rule that distinguishes "marches" from "monarchs".
    Matching is case insensitive because Plover compiles the rules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
